alex-frolov/dsp-adau1452/(commit log)

2020-02-23 add new test - button selection
2020-03-28 new 2 subprojects: arduino mute control and arduino as full contoller of DSP
2020-10-06 add arduino controlled with redio control via RF24L01
